ATrappmann/RoboRemote/RoboRemote-Controller_v2/RoboRemote-Controller_v2.ino

// NAME: RoboRemote-Controller_v2.ino
//
// DESC: Sketch for RoboRemote bluetooth remote controller.
//       see https://www.youtube.com/watch?v=xHsCnpfgwEI for Part 1
//       and https://www.youtube.com/watch?v=I3VOlUwofhE for Part 2
//       and https://www.youtube.com/watch?v=15aVeGGLiDI for Part 3
//
// SOURCE: Code is available at https://github.com/ATrappmann/RoboRemote
//
// USES LIBRARIES:
//  I2C Liquid Crystal from https://github.com/fdebrabander/Arduino-LiquidCrystal-I2C-library
// or
//  I2C LiquidCrystal from https://github.com/ATrappmann/LiquidCrystal_MCP23017_I2C
// and
//  EasyTransfer from https://github.com/madsci1016/Arduino-EasyTransfer
//  LCDMenuController from https://github.com/ATrappmann/LCDMenuController
//
// MIT License
//
// Copyright (c) 2020-21 Andreas Trappmann
//
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

#include <EasyTransfer.h>
#include <LCDMenuController.h>

#include "RoboRemote_Pins.h"
#include "LCD.h"
#include "Menus.h"
#include "Bluetooth.h"

#define RIGHT_BTN_MASK  (1<<0)
#define UP_BTN_MASK     (1<<1)
#define ENTER_BTN_MASK  (1<<2)
#define DOWN_BTN_MASK   (1<<3)
#define LEFT_BTN_MASK   (1<<4)
#define RED_BTN_MASK    (1<<5)
#define GREEN_BTN_MASK  (1<<6)
#define JSK_BTN_MASK    (1<<7)

struct SEND_DATA {
  uint8_t   version;
  uint32_t  packetNo;
  uint8_t   buttons;
  uint16_t  jsk_roll;
  uint16_t  jsk_pitch;
  uint16_t  jsk_yaw;
  uint16_t  pot;
} txData;

EasyTransfer ET;
LCDMenuController menu = LCDMenuController(&lcd, 16, 2, DOWN_BTN_PIN, UP_BTN_PIN, ENTER_BTN_PIN, RED_BTN_PIN);

extern String sendCommand(const char *cmd);
extern String getStatus(const String& response);

void setup() {
  pinMode(RIGHT_BTN_PIN, INPUT_PULLUP);
  pinMode(UP_BTN_PIN, INPUT_PULLUP);
  pinMode(ENTER_BTN_PIN, INPUT_PULLUP);
  pinMode(DOWN_BTN_PIN, INPUT_PULLUP);
  pinMode(LEFT_BTN_PIN, INPUT_PULLUP);
  pinMode(RED_BTN_PIN, INPUT_PULLUP);
  pinMode(GREEN_BTN_PIN, INPUT_PULLUP);

  pinMode(BLUE_LED_PIN, OUTPUT);
  pinMode(RED_LED_PIN, OUTPUT);
  pinMode(GREEN_LED_PIN, OUTPUT);
  pinMode(YELLOW_LED_PIN, OUTPUT);

  pinMode(BT_CMD_PIN, OUTPUT);
  pinMode(BT_STATE_PIN, INPUT);

  pinMode(JSK_ROLL_PIN, INPUT);
  pinMode(JSK_PITCH_PIN, INPUT);
  pinMode(JSK_YAW_PIN, INPUT);
  pinMode(JSK_BTN_PIN, INPUT_PULLUP);

  pinMode(POT_PIN, INPUT);

  digitalWrite(BT_CMD_PIN, HIGH); 
  digitalWrite(BLUE_LED_PIN, LOW);

  ET.begin(details(txData), &BTserial);
  txData.version = (MAJOR << 4) | MINOR;
  txData.packetNo = 0L;

  menu.init();
  menu.begin(mainMenu);
}

void loop() {
  menu.navigate();
}

void *remoteControl() {
  if (!digitalRead(BT_STATE_PIN)) { // not paired
    digitalWrite(BLUE_LED_PIN, LOW);  // switch off blue LED
    while (!digitalRead(BT_STATE_PIN)); // wait for pairing
  }
  else digitalWrite(BLUE_LED_PIN, HIGH);  // paired

  txData.packetNo++;
  txData.buttons = 0;
  if (digitalRead(RIGHT_BTN_PIN)) txData.buttons |= RIGHT_BTN_MASK;
  if (digitalRead(UP_BTN_PIN))    txData.buttons |= UP_BTN_MASK;
  if (digitalRead(ENTER_BTN_PIN)) txData.buttons |= ENTER_BTN_MASK;
  if (digitalRead(DOWN_BTN_PIN))  txData.buttons |= DOWN_BTN_MASK;
  if (digitalRead(LEFT_BTN_PIN))  txData.buttons |= LEFT_BTN_MASK;
  if (digitalRead(RED_BTN_PIN))   txData.buttons |= RED_BTN_MASK;
  if (digitalRead(GREEN_BTN_PIN)) txData.buttons |= GREEN_BTN_MASK;
  if (digitalRead(JSK_BTN_PIN))   txData.buttons |= JSK_BTN_MASK;
  txData.buttons = ~txData.buttons; // redo logic inversion through pullup resistors
  txData.jsk_roll = analogRead(JSK_ROLL_PIN);
  txData.jsk_pitch= analogRead(JSK_PITCH_PIN);
  txData.jsk_yaw  = analogRead(JSK_YAW_PIN);
  txData.pot = analogRead(POT_PIN);
  ET.sendData();

  lcd.setCursor(0, 1);
  lcd.print(txData.packetNo);

  return remoteControl;
}
