ATrappmann/RoboRemote/RoboRemote-Controller_v2/RoboRemote_Pins.h

// NAME: RoboRemotePins.h
//
#ifndef ROBOREMOTE_PINS_H
#define ROBOREMOTE_PINS_H

#define RIGHT_BTN_PIN   2
#define UP_BTN_PIN      3
#define ENTER_BTN_PIN   4
#define DOWN_BTN_PIN    5
#define LEFT_BTN_PIN    6
#define RED_BTN_PIN     7
#define GREEN_BTN_PIN   8

#define BLUE_LED_PIN    10
#define RED_LED_PIN     11
#define GREEN_LED_PIN   12
#define YELLOW_LED_PIN  13

#define BT_CMD_PIN      A0
#define BT_STATE_PIN    9

#define JSK_ROLL_PIN    A6
#define JSK_PITCH_PIN   A1
#define JSK_YAW_PIN     A2
#define JSK_BTN_PIN     A3

#define POT_PIN         A7

#endif
